G-Force-WRO/Wro-Future-Engineers/v-photos/Back view.jpg

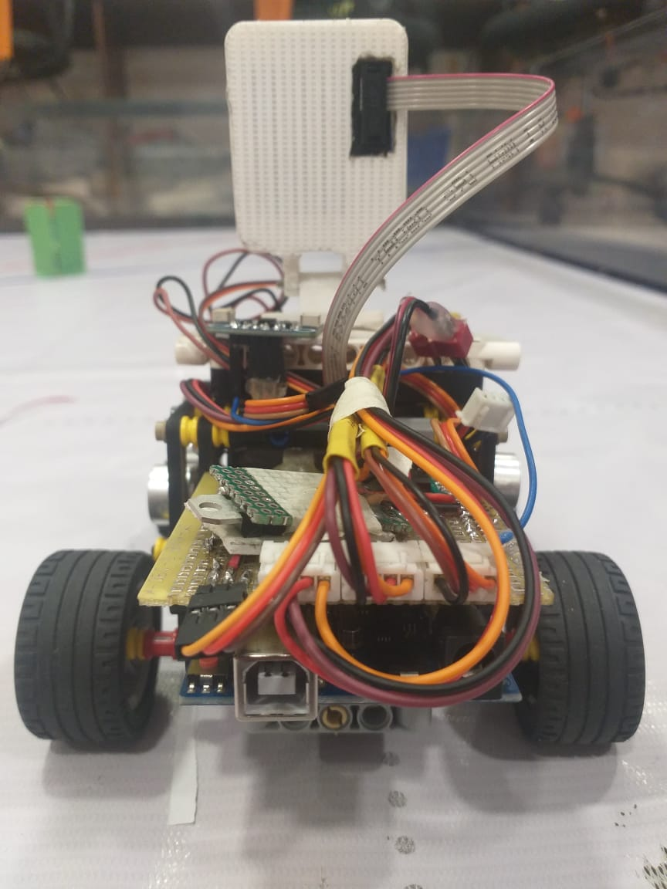
v-photos/Back view.jpg
