G-Force-WRO/Wro-Future-Engineers/v-photos/Front View.jpg

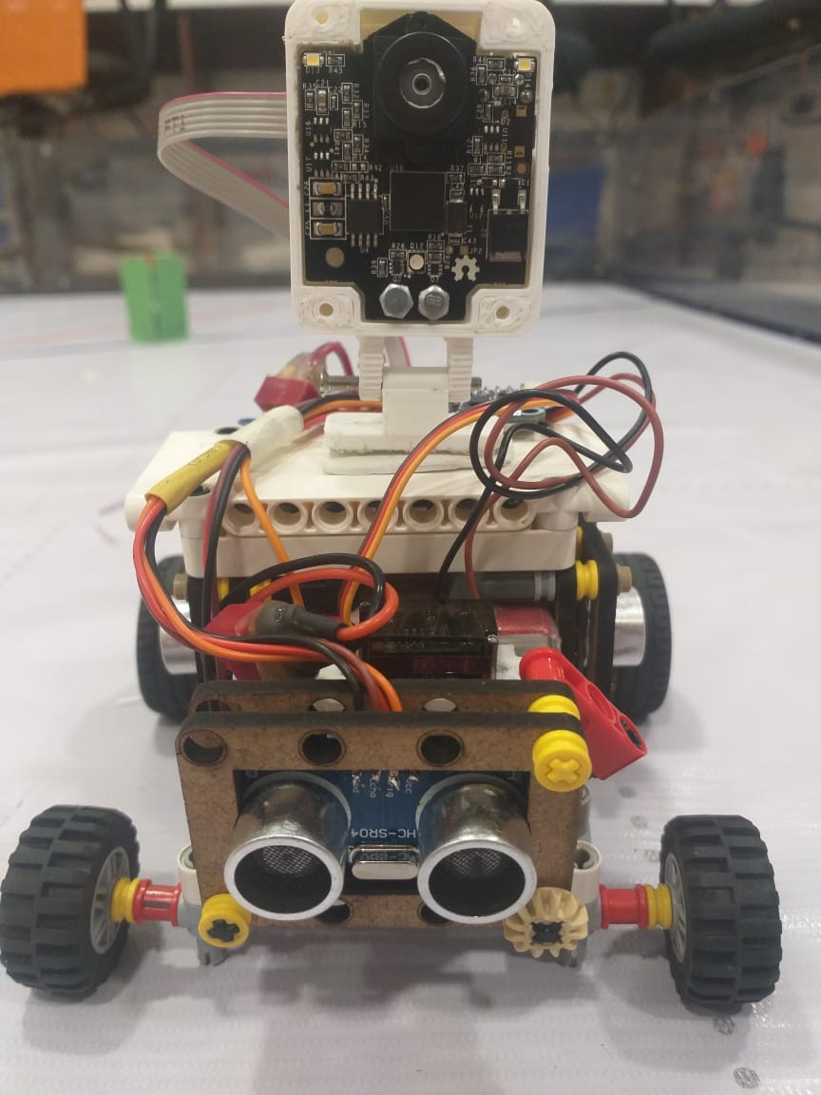
v-photos/Front View.jpg
