G-Force-WRO/Wro-Future-Engineers/schemes/README.md

Electromechanical diagrams
====

This directory must contain one mechanical diagram and one electric diagram in form of JPEG of the electromechanical components illustrating all the elements (electronic components and motors) used in the vehicle and how they connect to each other.
