G-Force-WRO/Wro-Future-Engineers/models/Chassis+Pixy Mount.jpeg

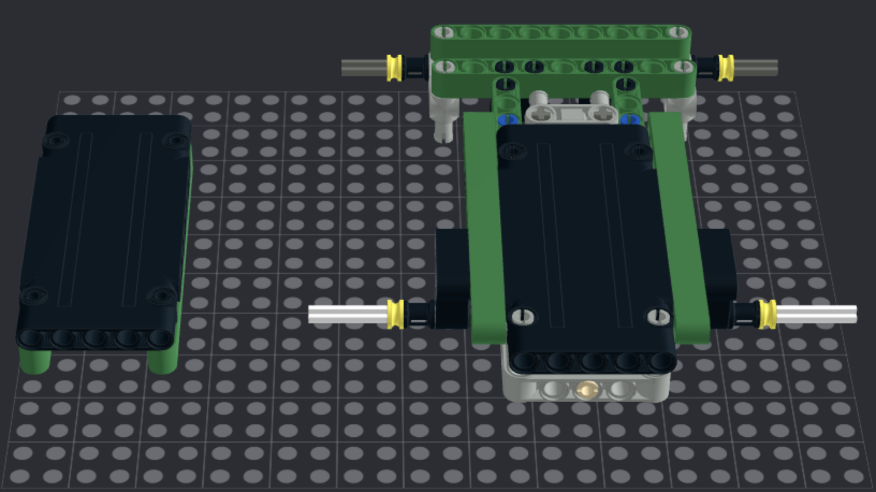
models/Chassis+Pixy Mount.jpeg
