G-Force-WRO/Wro-Future-Engineers/schemes/Electric Diagram.jpeg

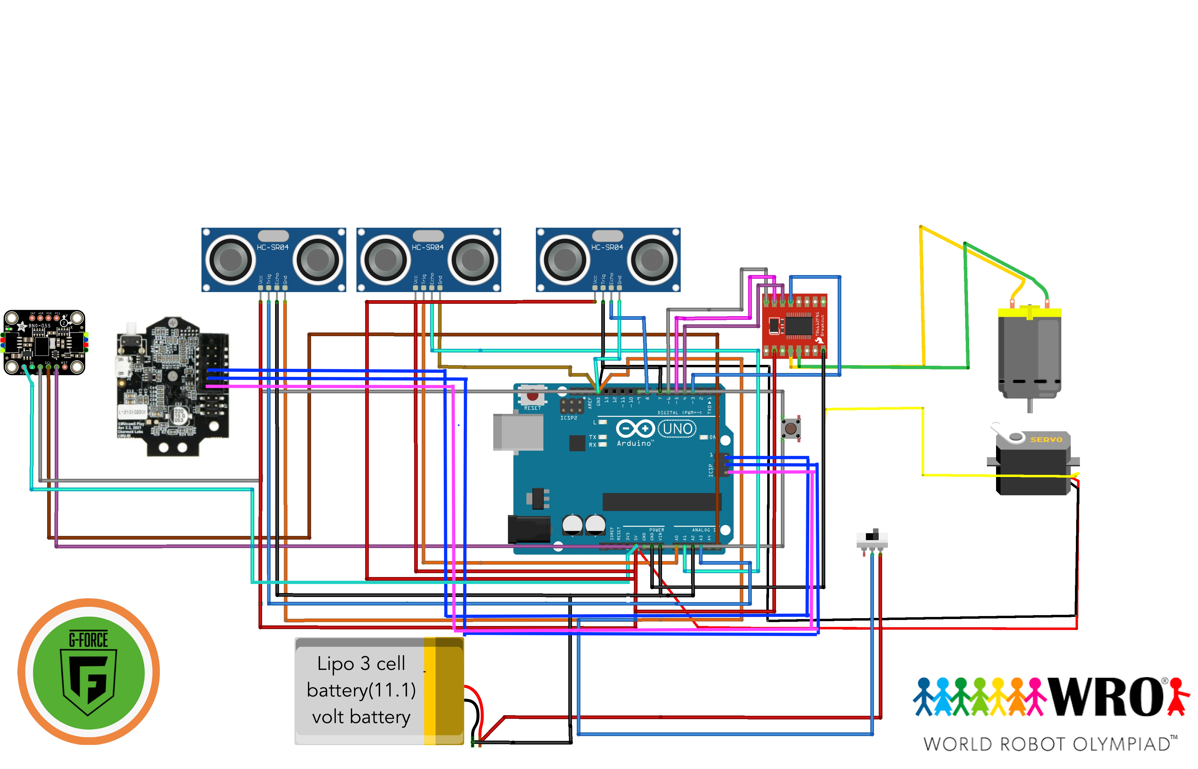
schemes/Electric Diagram.jpeg
