G-Force-WRO/Wro-Future-Engineers/schemes/Mechanical Diagram.jpg

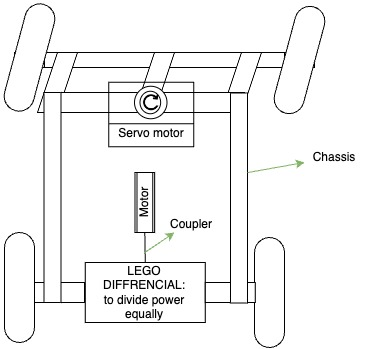
schemes/Mechanical Diagram.jpg
