G-Force-WRO/Wro-Future-Engineers/t-photos/Funny Picture.jpeg

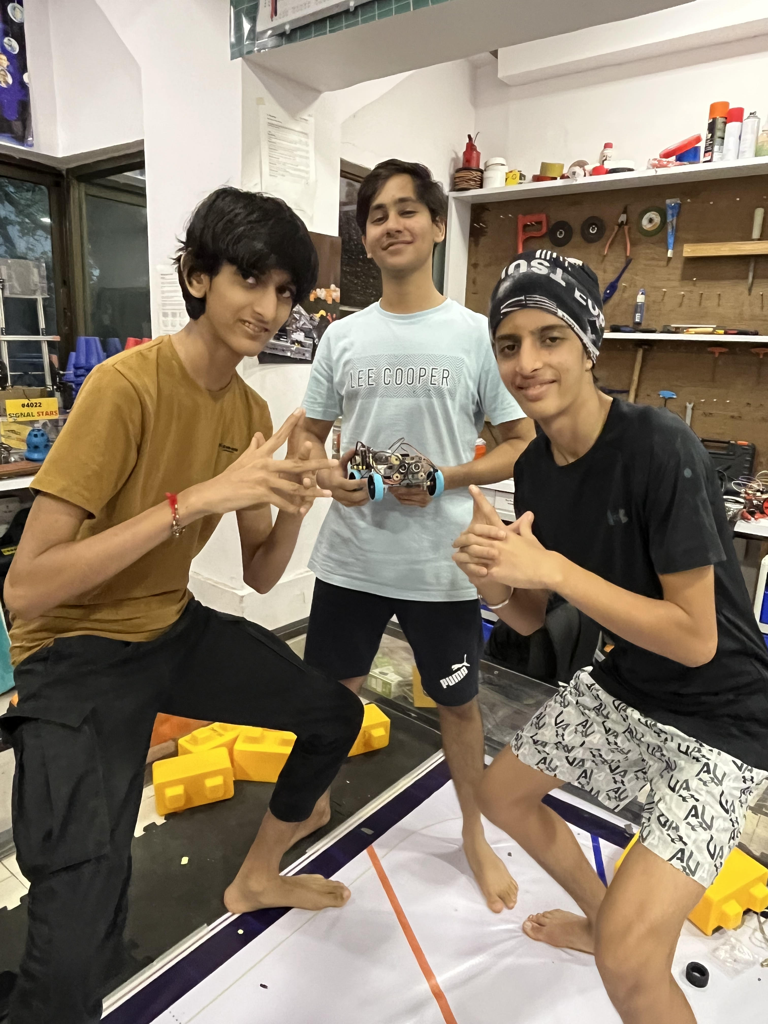
t-photos/Funny Picture.jpeg
