G-Force-WRO/Wro-Future-Engineers/t-photos/Official picture.jpeg

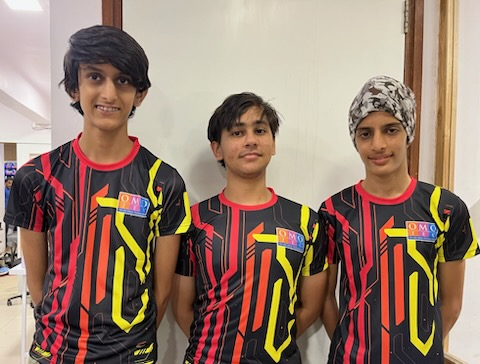
t-photos/Official picture.jpeg
