G-Force-WRO/Wro-Future-Engineers/v-photos/Bottom View.jpg

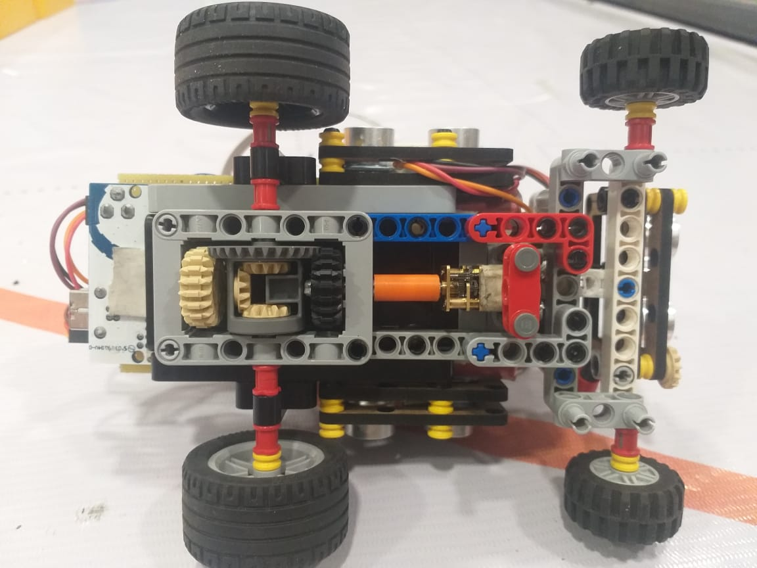
v-photos/Bottom View.jpg
