G-Force-WRO/Wro-Future-Engineers/v-photos/Left View.jpg

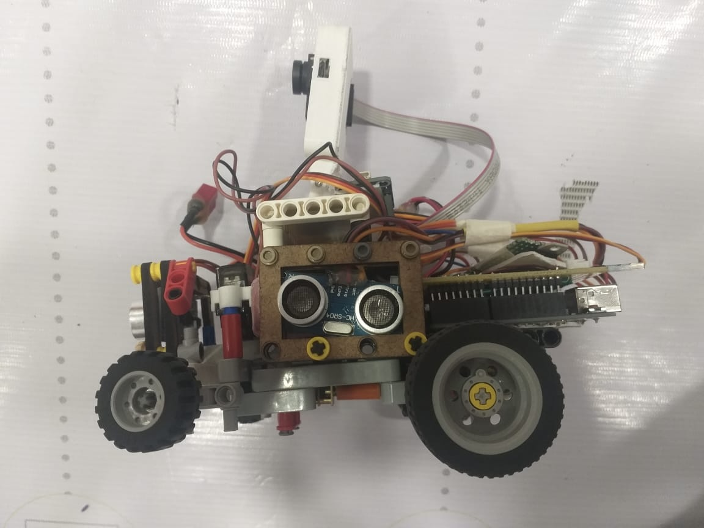
v-photos/Left View.jpg
