G-Force-WRO/Wro-Future-Engineers/v-photos/Right view.jpg

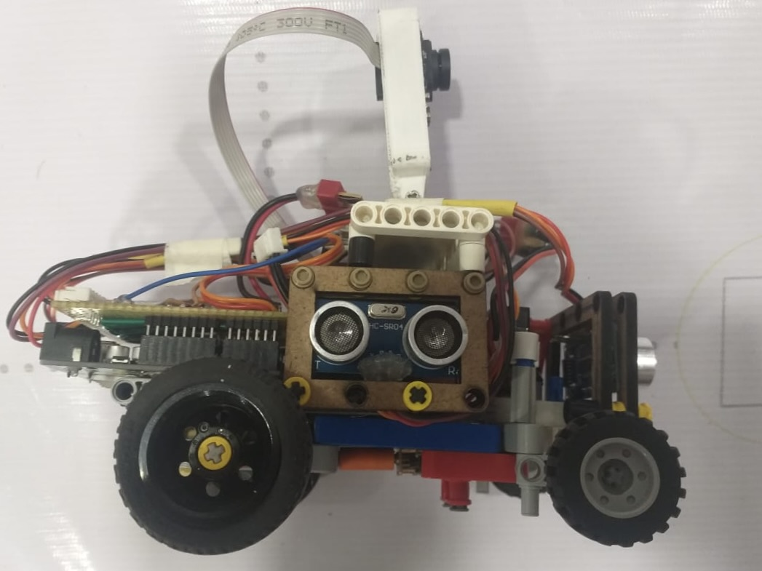
v-photos/Right view.jpg
