G-Force-WRO/Wro-Future-Engineers/v-photos/Top view.jpg

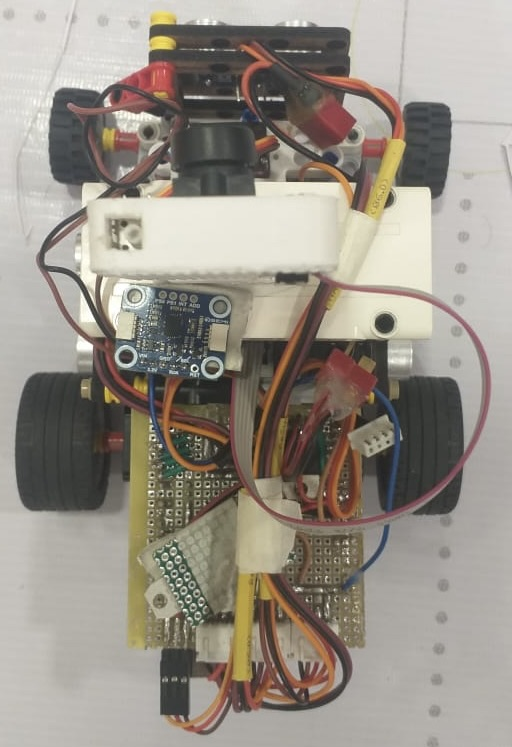
v-photos/Top view.jpg
