G-Force-WRO/Wro-Future-Engineers/models/SG90 Shell.stl

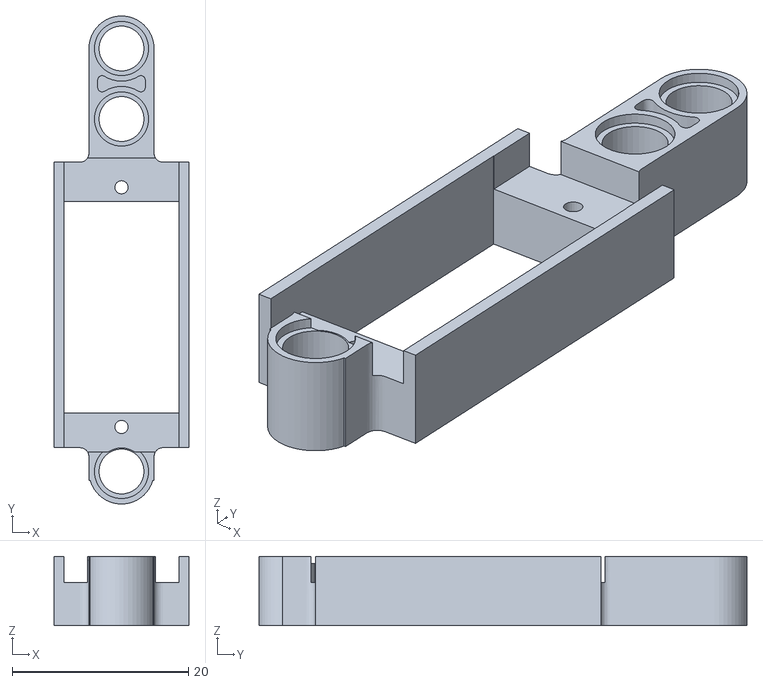
[picture p12: CAD file, 2023-09-28]
models/SG90 Shell.stl
15.3 x 55.4 x 7.85
