G-Force-WRO/Wro-Future-Engineers/models/Horn Beam.stl

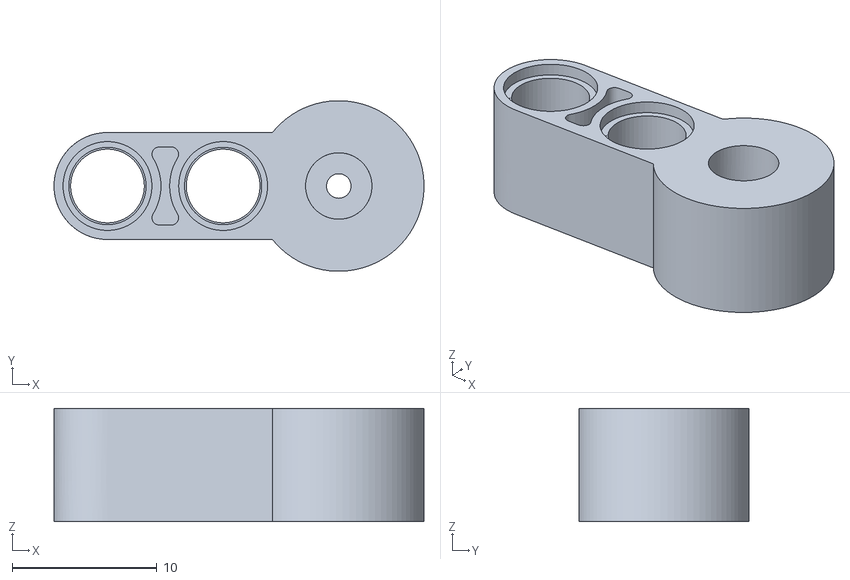
[picture p13: CAD file, 2023-09-28]
models/Horn Beam.stl
25.6 x 11.8 x 7.85
