G-Force-WRO/Wro-Future-Engineers/models/PixyCam2 casev3 (1).stl

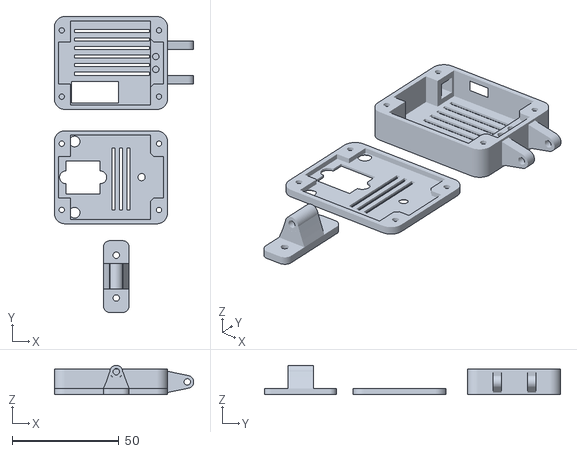
[picture p14: CAD file, 2023-09-27]
models/PixyCam2 casev3 (1).stl
65.2 x 138.5 x 13.8
