G-Force-WRO/Wro-Future-Engineers/(commit log)

2023-09-21 Create Servo_code
2023-09-28 Add files via upload
    {All wires are not shown in the pixy 2 camera connection but it is an SPI buzz.}
